ali-sarfraz/tesseract-retriever/README.md

# Autonomous Tesseract Retriever
Autonomous robot design project responsible for the retrieval of a magnetic tesseract and placing it underneath another pyramid shaped object.

Coding is done in the Arduino language for the ATMEGA328P microcontroller and VEX robotics components were used for building the robot and it's sensors and actuators.
